hsetlik/CompressorPedal/CompressorPCB/CompressorPCB.kicad_pcb

## KiCad design CompressorPCB/CompressorPCB.kicad_pcb (2026-10-30)

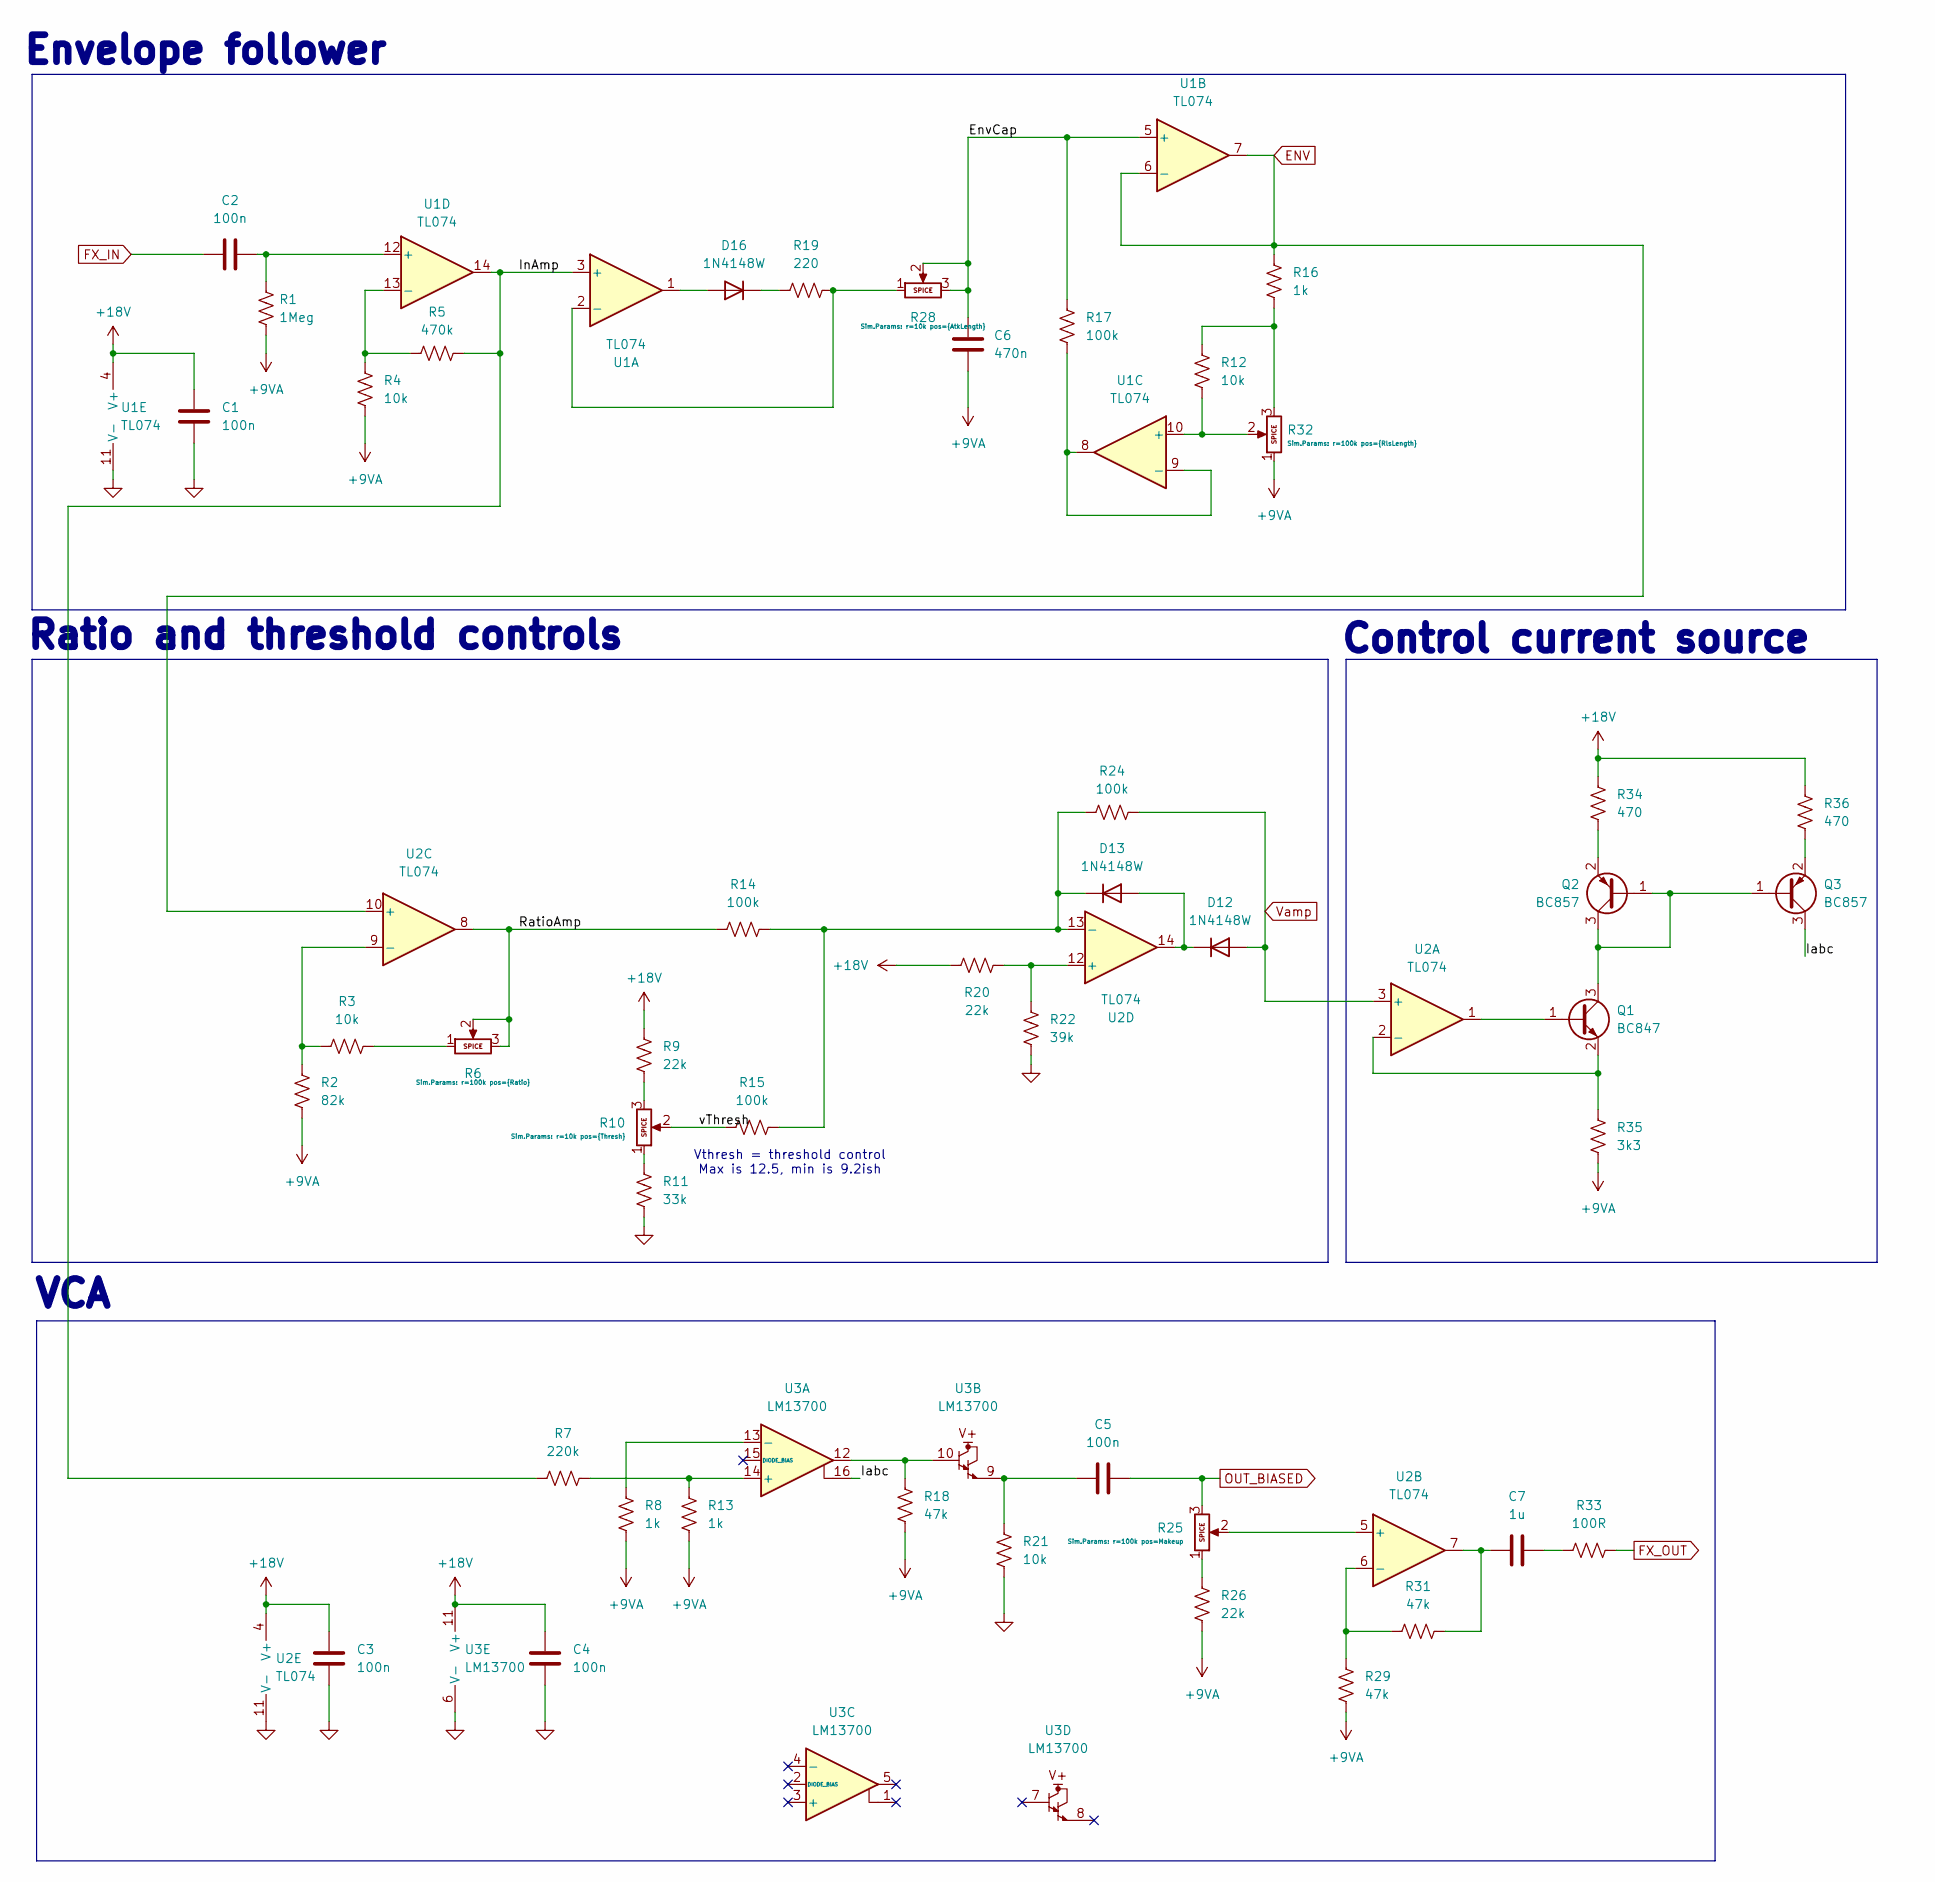
[picture p1: schematic Analog.kicad_sch]

Parts:
C1, C2, C3, C4, C5: 100n; C_0805_2012Metric
C6: 470n; C_0805_2012Metric
C7: 1u; C_0805_2012Metric
D12, D13, D16: 1N4148W; D_SOD-123
Q1: BC847; SOT-23
Q2, Q3: BC857; SOT-23
R1: 1Meg; R_0805_2012Metric
R2: 82k; R_0805_2012Metric
R3, R4, R12, R21: 10k; R_0805_2012Metric
R5: 470k; R_0805_2012Metric
R6, R10, R25, R28, R32: Potentiometer; Potentiometer_Alpha_RV16AF_42_Single_Long
R7: 220k; R_0805_2012Metric
R8, R13, R16: 1k; R_0805_2012Metric
R9, R20, R26: 22k; R_0805_2012Metric
R11: 33k; R_0805_2012Metric
R14, R15, R17, R24: 100k; R_0805_2012Metric
R18, R29, R31: 47k; R_0805_2012Metric
R19: 220; R_0805_2012Metric
R22: 39k; R_0805_2012Metric
R33: 100R; R_0805_2012Metric
R34, R36: 470; R_0805_2012Metric
R35: 3k3; R_0805_2012Metric
U1, U2: TL074; SOIC-14_3.9x8.7mm_P1.27mm
U3: LM13700; SOIC-16_3.9x9.9mm_P1.27mm

Connections:
+9VA: C6.2, R1.2, R2.2, R4.2, R8.2, R13.2, R18.2, R26.2, R29.1, R32.1, R35.1; also elsewhere on the board
+18V: C1.2, C3.2, C4.2, R9.1, R20.1, R34.2, R36.2, U1.4 (V+), U2.4 (V+), U3.11 (V+); also elsewhere on the board
/Analog/EnvCap: C6.1, R17.1, R28.2, R28.3, U1.5 (+)
/Analog/Iabc: Q3.3 (C), U3.16
/Analog/InAmp: R5.2, R7.1, U1.3 (+), U1.14
/Analog/RatioAmp: R6.2, R6.3, R14.1, U2.8
/Analog/vThresh: R10.2, R15.1
ENV: R16.1, U1.6 (-), U1.7, U2.10 (+); also elsewhere on the board
FX_IN: C2.1; also elsewhere on the board
FX_OUT: R33.2; also elsewhere on the board
GND: C1.1, C3.1, C4.1, R11.2, R21.2, R22.1, U1.11 (V-), U2.11 (V-), U3.6 (V-); also elsewhere on the board
unnamed: C5.1, R21.1, U3.9
unnamed: C7.1, R31.2, U2.7
unnamed: C7.2, R33.1
unnamed: D12.1 (K), D13.2 (A), U2.14
unnamed: D13.1 (K), R14.2, R15.2, R24.1, U2.13 (-)
unnamed: D16.2 (A), U1.1
unnamed: D16.1 (K), R19.1
unnamed: Q1.1 (B), U2.1
unnamed: Q1.3 (C), Q2.1 (B), Q2.3 (C), Q3.1 (B)
unnamed: Q1.2 (E), R35.2, U2.2 (-)
unnamed: Q2.2 (E), R34.1
unnamed: Q3.2 (E), R36.1
unnamed: R3.2, R6.1
unnamed: R10.1, R11.1
unnamed: R9.2, R10.3
unnamed: R12.1, R16.2, R32.3
unnamed: R18.1, U3.10, U3.12
unnamed: R25.1, R26.1
unnamed: R19.2, R28.1, U1.2 (-)
unnamed: R12.2, R32.2, U1.10 (+)
unnamed: R17.2, U1.8, U1.9 (-)
unnamed: C2.2, R1.1, U1.12 (+)
unnamed: R4.1, R5.1, U1.13 (-)
unnamed: R25.2, U2.5 (+)
unnamed: R29.2, R31.1, U2.6 (-)
unnamed: R2.1, R3.1, U2.9 (-)
unnamed: R20.2, R22.2, U2.12 (+)
unnamed: R7.2, R13.1, U3.14 (+)
unnamed: R8.1, U3.13 (-)
OUT_BIASED: C5.2, R25.3; also elsewhere on the board
Vamp: D12.2 (A), R24.2, U2.3 (+)

Notes on the sheet:
Vthresh = threshold control Max is 12.5, min is 9.2ish
Envelope follower
VCA
Control current source
Ratio and threshold controls

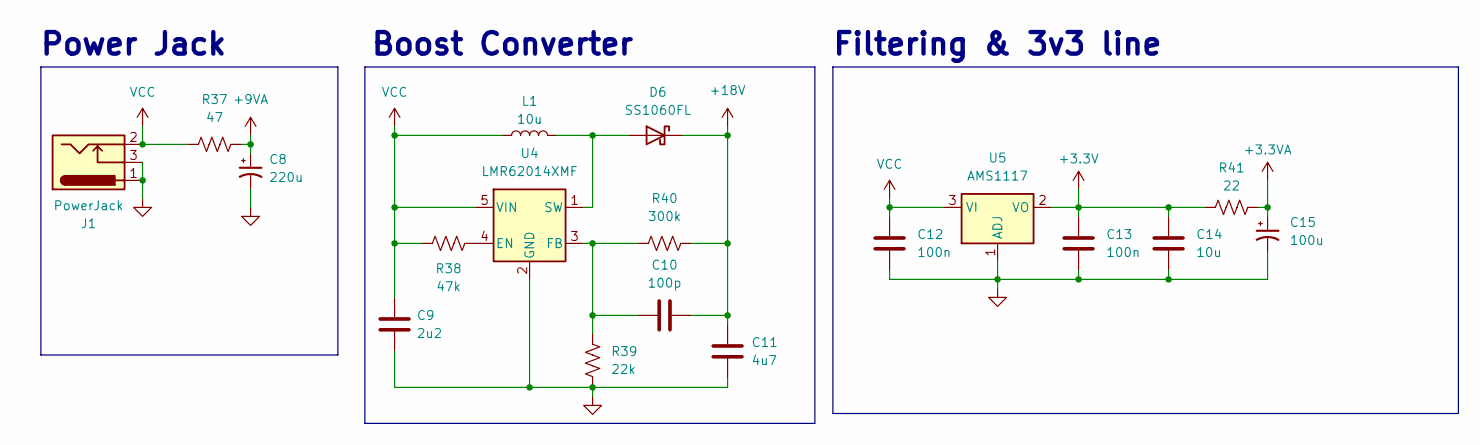
[picture p2: schematic Power.kicad_sch]

Parts:
C8: 220u; CP_Radial_D6.3mm_P2.50mm
C9: 2u2; C_0805_2012Metric
C10: 100p; C_0805_2012Metric
C11: 4u7; C_0805_2012Metric
C12, C13: 100n; C_0805_2012Metric; MPN KGF21BR71H104KT
C14: 10u; C_0805_2012Metric; MPN KGM21AR50J106KU
C15: 100u; CP_Radial_D6.3mm_P2.50mm
D6: SS1060FL; D_SOD-123F
J1: PowerJack; BarrelJack_Horizontal; MPN NEB 21 R-C
L1: 10u; L_SigTransformer_SLPPI04_15
R37: 47; R_0805_2012Metric
R38: 47k; R_0805_2012Metric
R39: 22k; R_0805_2012Metric
R40: 300k; R_0805_2012Metric
R41: 22; R_0805_2012Metric
U4: LMR62014XMF; SOT-23-5
U5: AMS1117; SOT-223-3_TabPin2; MPN LD1117S33CTR

Connections:
+3.3V: C13.2, C14.2, R41.2, U5.2 (VO); also elsewhere on the board
+3.3VA: C15.1, R41.1; also elsewhere on the board
+9VA: C8.1, R37.1; also elsewhere on the board
+18V: C10.2, C11.1, D6.1 (K), R40.2; also elsewhere on the board
GND: C8.2, C9.2, C11.2, C12.1, C13.1, C14.1, C15.2, J1.1, J1.3, R39.1, U4.2 (GND), U5.1 (ADJ); also elsewhere on the board
unnamed: D6.2 (A), L1.2, U4.1 (SW)
unnamed: R38.2, U4.4 (EN)
unnamed: C10.1, R39.2, R40.1, U4.3 (FB)
VCC: C9.1, C12.2, J1.2, L1.1, R37.2, R38.1, U4.5 (VIN), U5.3 (VI)

Notes on the sheet:
Filtering & 3v3 line
Boost Converter
Power Jack

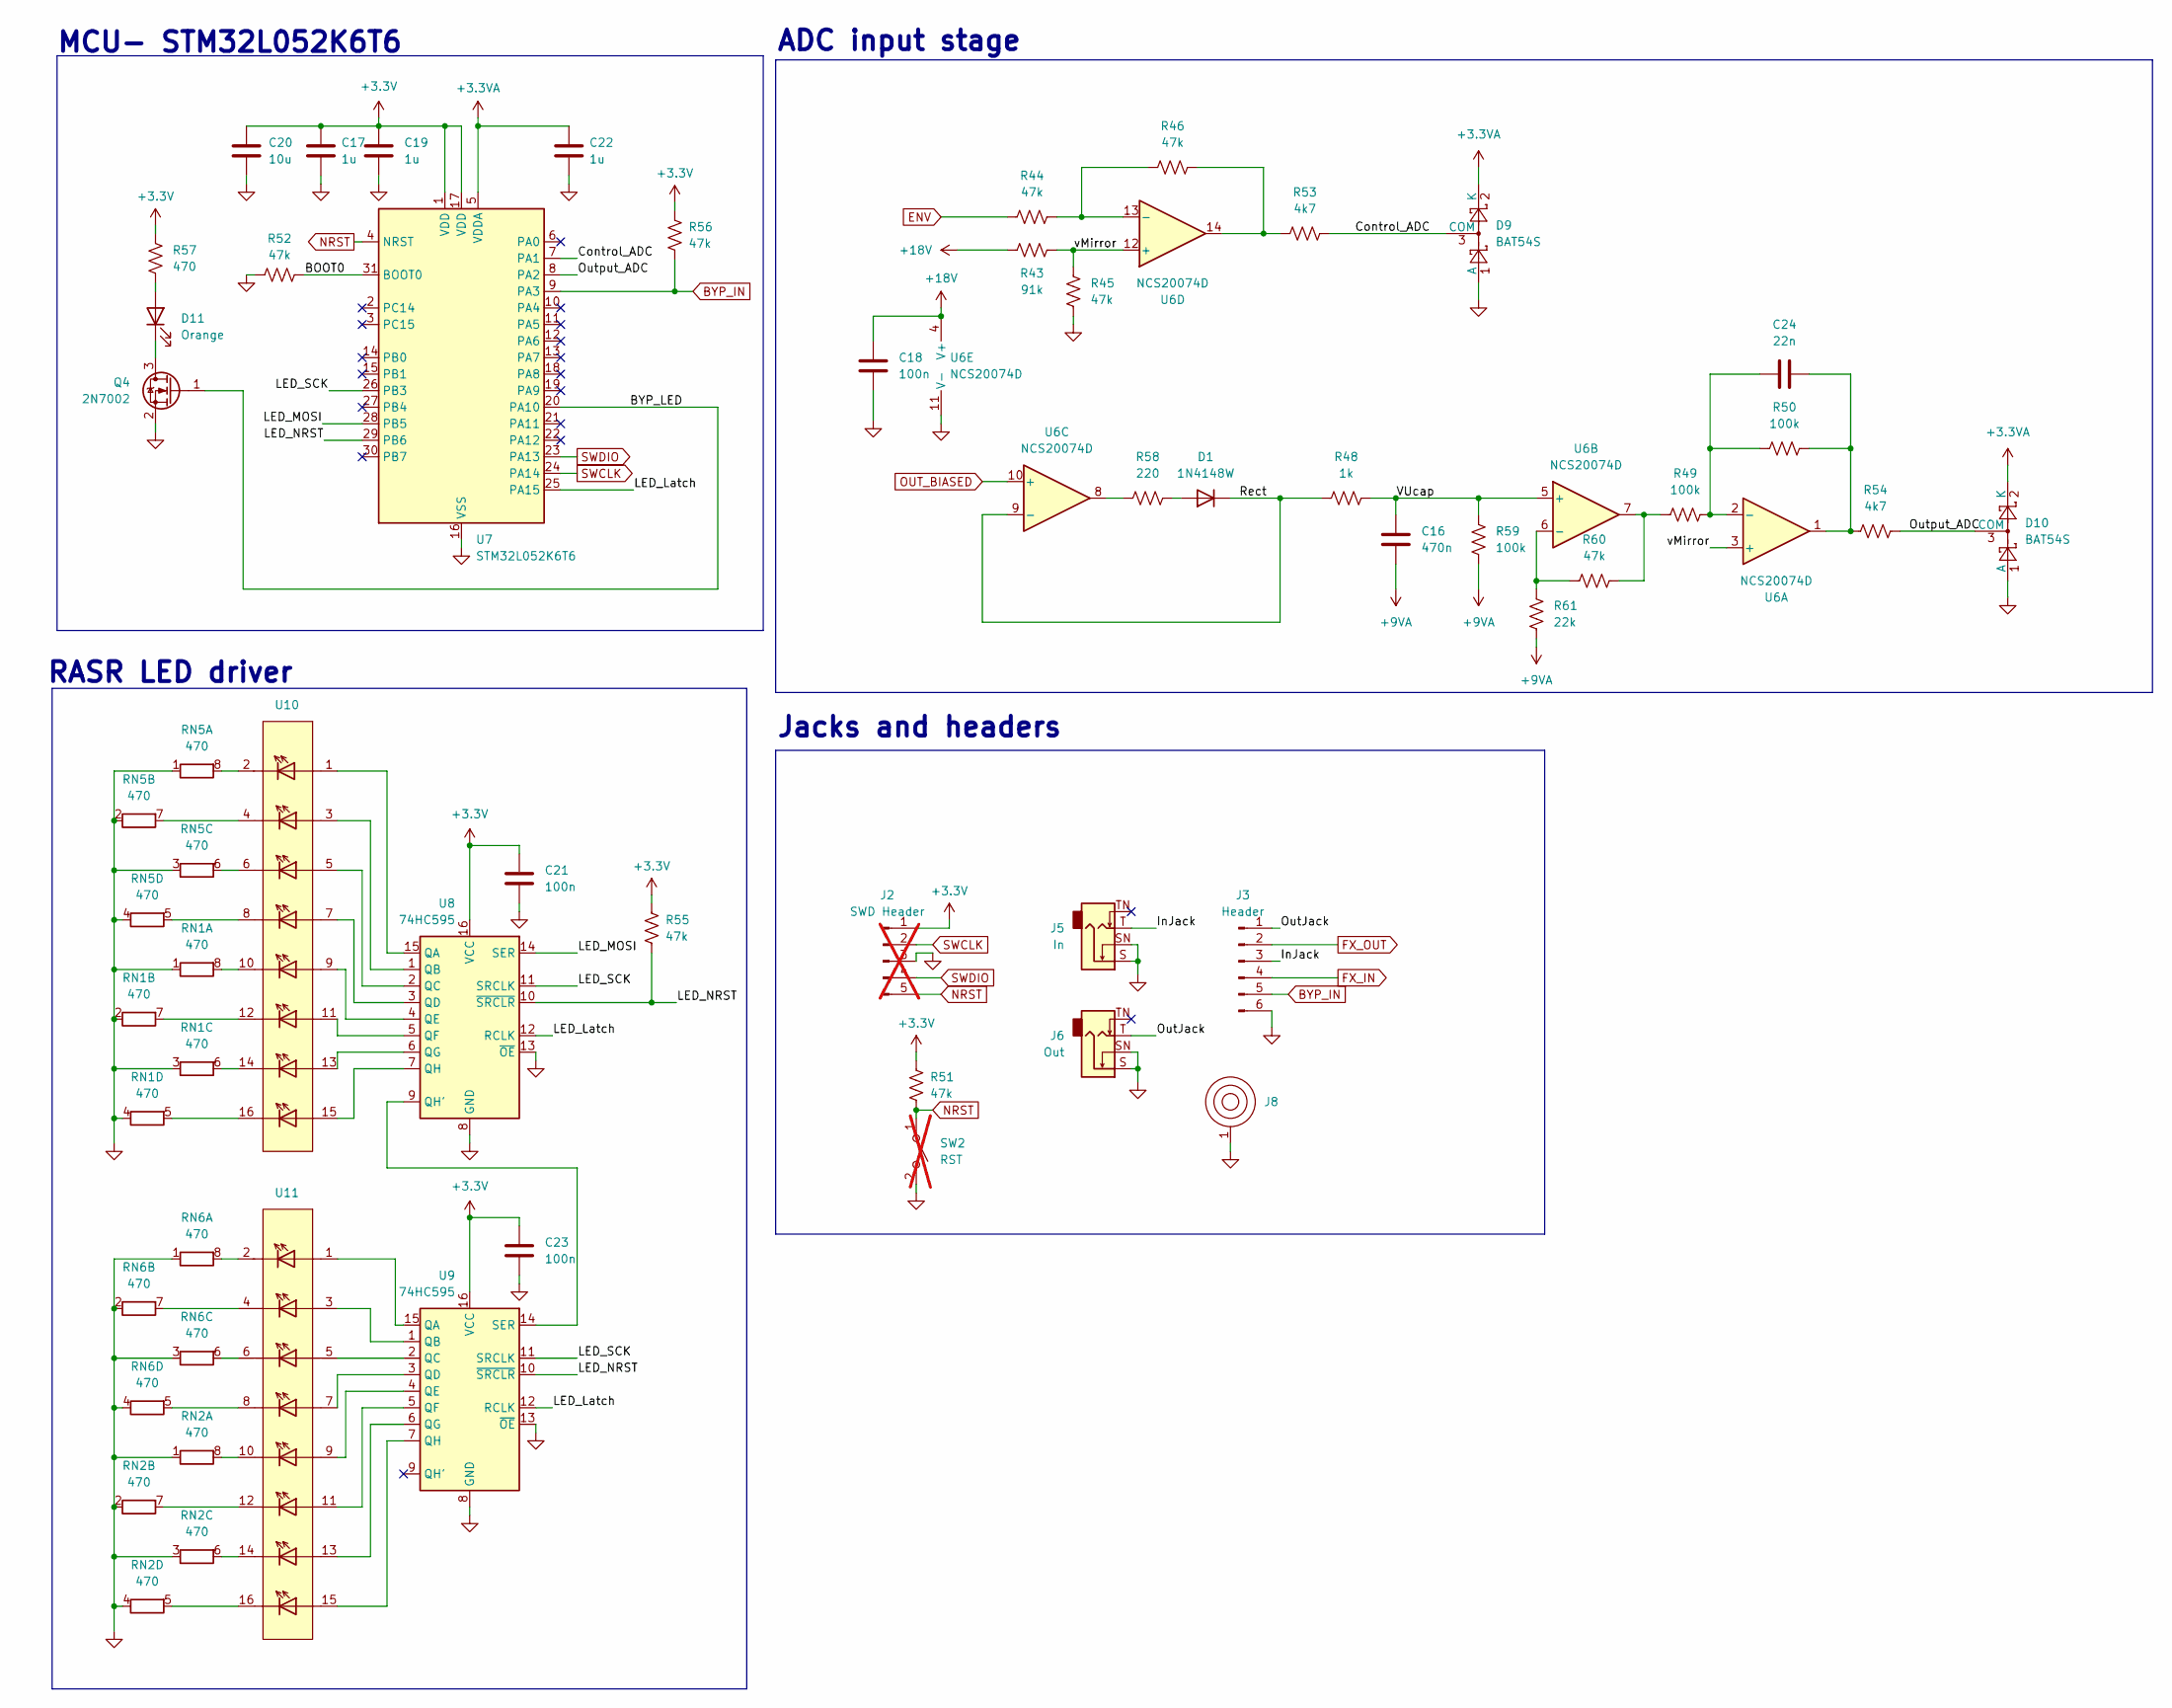
[picture p3: schematic Digital.kicad_sch]

Parts:
C16: 470n; C_0805_2012Metric
C17, C19, C22: 1u; C_0805_2012Metric
C18, C21, C23: 100n; C_0805_2012Metric
C20: 10u; C_0805_2012Metric
C24: 22n; C_0805_2012Metric
D1: 1N4148W; D_SOD-123
D9, D10: BAT54S; SOT-23
D11: Orange; LED_D3.0mm; MPN LTL-4291N
J2: SWD Header; PinHeader_1x05_P2.54mm_Vertical; not fitted
J3: Header; PinHeader_1x06_P2.54mm_Vertical
J5: In; Jack_6.35mm_Tayda_PJ664C_Mono_Horizontal; MPN PJ-644C MONO
J6: Out; Jack_6.35mm_Tayda_PJ664C_Mono_Horizontal; MPN PJ-644C MONO
J8: BatteryContact_Keystone_243
Q4: 2N7002; SOT-23; MPN 2N7002NXAKR
R43: 91k; R_0805_2012Metric
R44, R45, R46, R52, R60: 47k; R_0805_2012Metric
R48: 1k; R_0805_2012Metric
R49, R50, R59: 100k; R_0805_2012Metric
R51, R55, R56: 47k; R_0805_2012Metric; MPN RK73B2ATTE473J
R53, R54: 4k7; R_0805_2012Metric
R57: 470; R_0805_2012Metric; MPN RC0805JR-10470RL
R58: 220; R_0805_2012Metric
R61: 22k; R_0805_2012Metric
RN1, RN2, RN5, RN6: 470; R_Cat16-4
SW2: RST; SW_SPST_B3U-1000P; not fitted
U6: NCS20074D; SOIC-14_3.9x8.7mm_P1.27mm
U7: STM32L052K6T6; LQFP-32_7x7mm_P0.8mm
U8, U9: 74HC595; SOIC-16_3.9x9.9mm_P1.27mm
U10, U11: LED_OctoLED_0805

Connections:
+3.3V: C17.1, C19.1, C20.1, C21.1, C23.1, J2.1, R51.1, R55.1, R56.1, R57.1, U7.1 (VDD), U7.17 (VDD), U8.16 (VCC), U9.16 (VCC); also elsewhere on the board
+3.3VA: C22.1, D9.2 (K), D10.2 (K), U7.5 (VDDA); also elsewhere on the board
+9VA: C16.2, R59.1, R61.2; also elsewhere on the board
+18V: C18.1, R43.1, U6.4 (V+); also elsewhere on the board
/Digital/BOOT0: R52.2, U7.31 (BOOT0)
/Digital/BYP_LED: Q4.1 (G), U7.20 (PA10)
/Digital/Control_ADC: D9.3 (COM), R53.2, U7.7 (PA1)
/Digital/InJack: J3.3, J5.T
/Digital/LED_Latch: U7.25 (PA15), U8.12 (RCLK), U9.12 (RCLK)
/Digital/LED_MOSI: U7.28 (PB5), U8.14 (SER)
/Digital/LED_NRST: R55.2, U7.29 (PB6), U8.10 (~SRCLR), U9.10 (~SRCLR)
/Digital/LED_SCK: U7.26 (PB3), U8.11 (SRCLK), U9.11 (SRCLK)
/Digital/OutJack: J3.1, J6.T
/Digital/Output_ADC: D10.3 (COM), R54.2, U7.8 (PA2)
/Digital/Rect: D1.1 (K), R48.1, U6.9 (-)
/Digital/VUcap: C16.1, R48.2, R59.2, U6.5 (+)
/Digital/vMirror: R43.2, R45.2, U6.3 (+), U6.12 (+)
BYP_IN: J3.5, R56.2, U7.9 (PA3)
ENV: R44.1; also elsewhere on the board
FX_IN: J3.4; also elsewhere on the board
FX_OUT: J3.2; also elsewhere on the board
GND: C17.2, C18.2, C19.2, C20.2, C21.2, C22.2, C23.2, D9.1 (A), D10.1 (A), J2.3, J3.6, J5.S, J5.SN, J6.S, J6.SN, J8.1, Q4.2 (S), R45.1, R52.1, RN1.1 (R1.1), RN1.2 (R2.1), RN1.3 (R3.1), RN1.4 (R4.1), RN2.1 (R1.1), RN2.2 (R2.1), RN2.3 (R3.1), RN2.4 (R4.1), RN5.1 (R1.1), RN5.2 (R2.1), RN5.3 (R3.1), RN5.4 (R4.1), RN6.1 (R1.1), RN6.2 (R2.1), RN6.3 (R3.1), RN6.4 (R4.1), SW2.2 (B), U6.11 (V-), U7.16 (VSS), U7.32 (VSS), U8.8 (GND), U8.13 (~OE), U9.8 (GND), U9.13 (~OE); also elsewhere on the board
NRST: J2.5, R51.2, SW2.1 (A), U7.4 (NRST)
unnamed: C24.2, R50.2, R54.1, U6.1
unnamed: D1.2 (A), R58.2
unnamed: D11.2 (A), R57.2
unnamed: D11.1 (K), Q4.3 (D)
unnamed: R46.2, R53.1, U6.14
unnamed: R49.1, R60.1, U6.7
unnamed: R58.1, U6.8
unnamed: RN1.8 (R1.2), U10.10 (2)
unnamed: RN1.7 (R2.2), U10.12 (2)
unnamed: RN1.6 (R3.2), U10.14 (2)
unnamed: RN1.5 (R4.2), U10.16 (2)
unnamed: RN2.8 (R1.2), U11.10 (2)
unnamed: RN2.7 (R2.2), U11.12 (2)
unnamed: RN2.6 (R3.2), U11.14 (2)
unnamed: RN2.5 (R4.2), U11.16 (2)
unnamed: RN5.8 (R1.2), U10.2
unnamed: RN5.7 (R2.2), U10.4 (2)
unnamed: RN5.6 (R3.2), U10.6 (2)
unnamed: RN5.5 (R4.2), U10.8 (2)
unnamed: RN6.8 (R1.2), U11.2
unnamed: RN6.7 (R2.2), U11.4 (2)
unnamed: RN6.6 (R3.2), U11.6 (2)
unnamed: RN6.5 (R4.2), U11.8 (2)
unnamed: C24.1, R49.2, R50.1, U6.2 (-)
unnamed: R60.2, R61.1, U6.6 (-)
unnamed: R44.2, R46.1, U6.13 (-)
unnamed: U8.15 (QA), U10.1
unnamed: U8.1 (QB), U10.3 (1)
unnamed: U8.2 (QC), U10.5 (1)
unnamed: U8.3 (QD), U10.7 (1)
unnamed: U8.4 (QE), U10.9 (1)
unnamed: U8.5 (QF), U10.11 (1)
unnamed: U8.6 (QG), U10.13 (1)
unnamed: U8.9 (QH'), U9.14 (SER)
unnamed: U8.7 (QH), U10.15 (1)
unnamed: U9.15 (QA), U11.1
unnamed: U9.1 (QB), U11.3 (1)
unnamed: U9.2 (QC), U11.5 (1)
unnamed: U9.3 (QD), U11.7 (1)
unnamed: U9.4 (QE), U11.9 (1)
unnamed: U9.5 (QF), U11.11 (1)
unnamed: U9.6 (QG), U11.13 (1)
unnamed: U9.7 (QH), U11.15 (1)
OUT_BIASED: U6.10 (+); also elsewhere on the board
SWCLK: J2.2, U7.24 (PA14)
SWDIO: J2.4, U7.23 (PA13)

Notes on the sheet:
ADC input stage
Jacks and headers
MCU- STM32L052K6T6
RASR LED driver

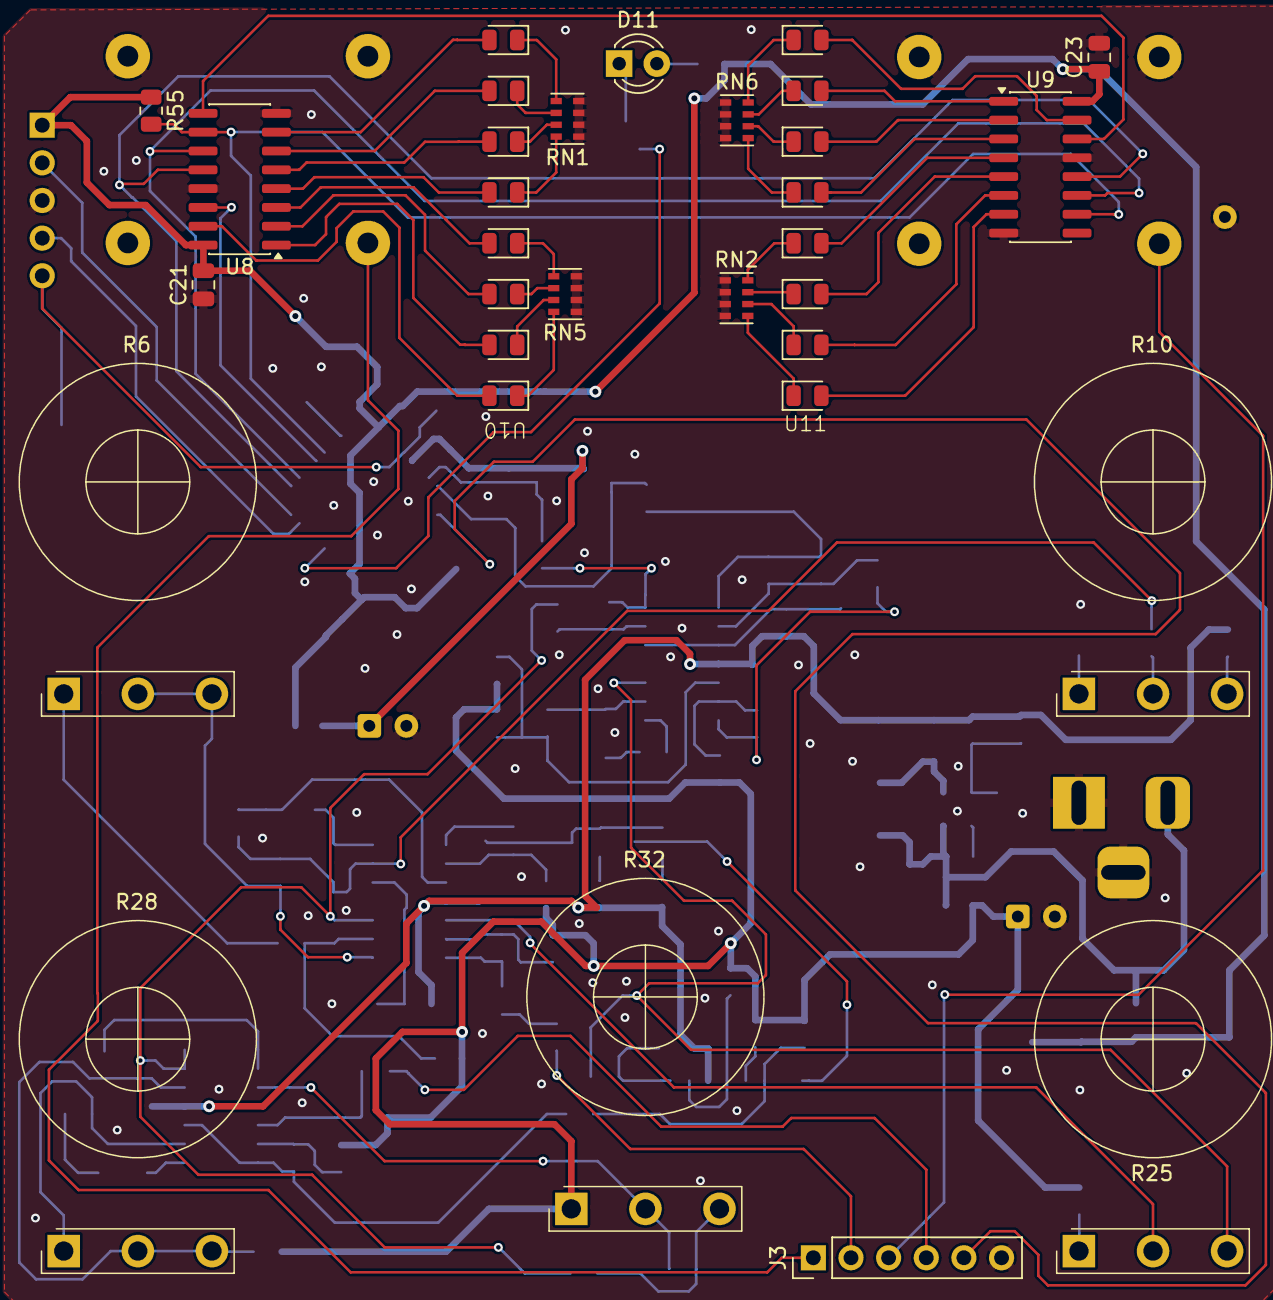
[picture p4: board CompressorPCB.kicad_pcb from above]

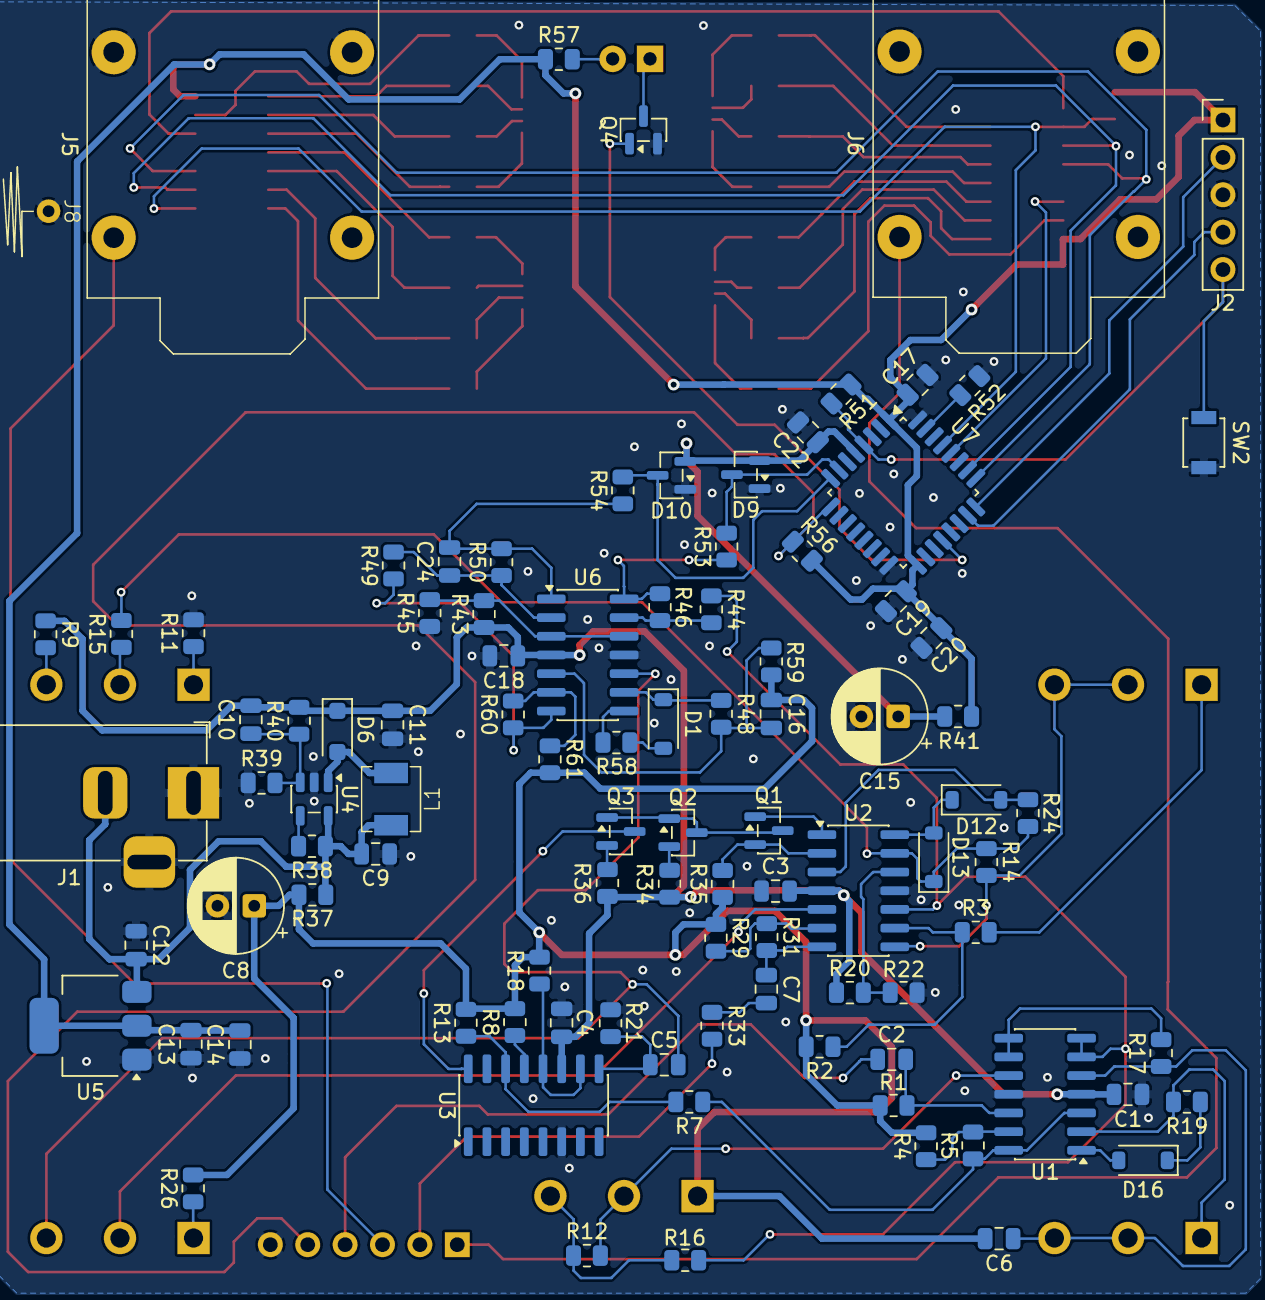
[picture p5: board CompressorPCB.kicad_pcb from below]

Board: 4 copper layers, 115 parts (97 on the bottom side), 108 nets.
