hsetlik/CompressorPedal/Simulations/ADCInputSim/ADCInputSim.kicad_sch

## KiCad design Simulations/ADCInputSim/ADCInputSim.kicad_sch (2026-10-27)

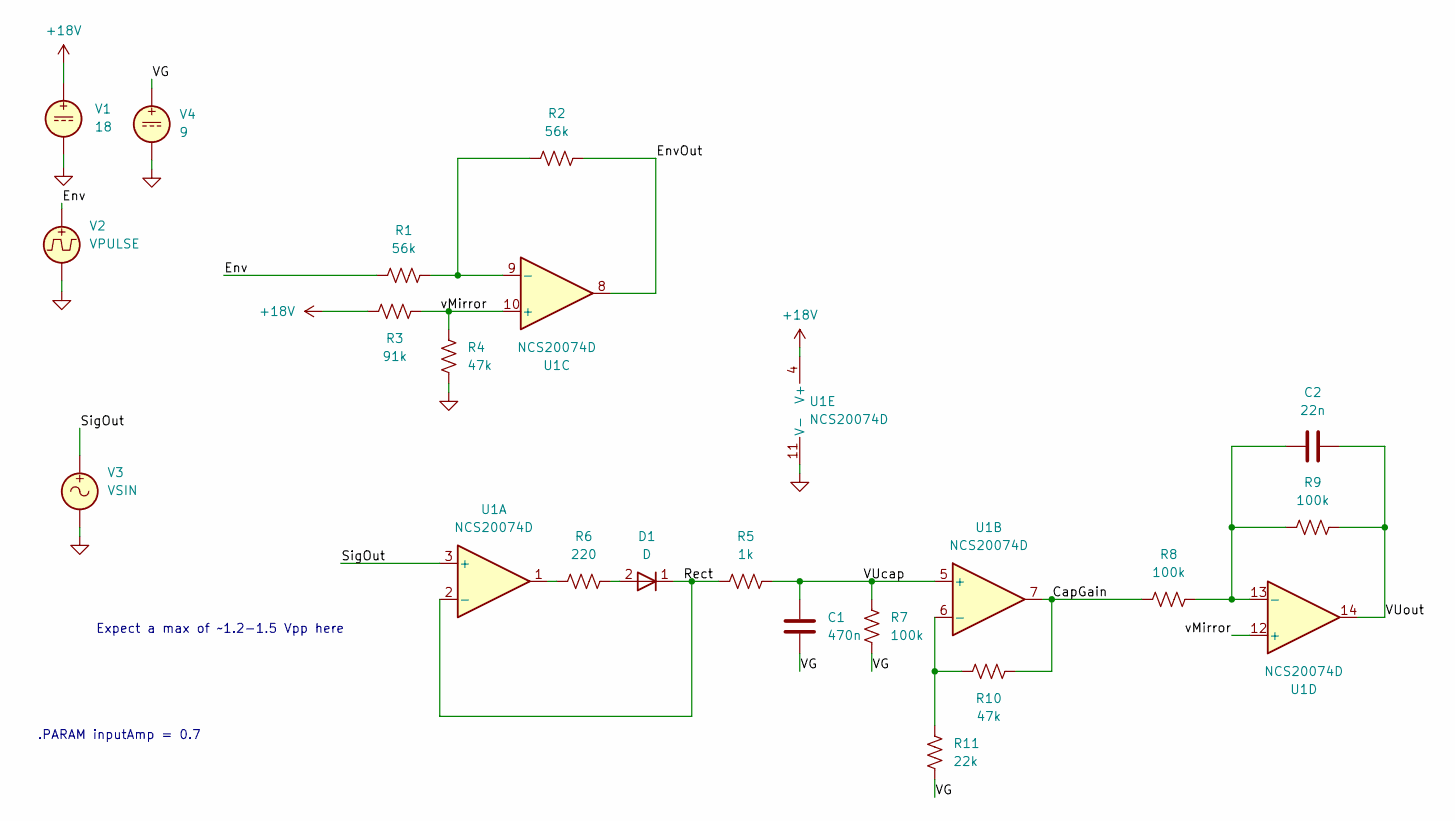
[picture p6: schematic ADCInputSim.kicad_sch]

Parts:
C1: 470n
C2: 22n
D1: D
R1, R2: 56k
R3: 91k
R4, R10: 47k
R5: 1k
R6: 220
R7, R8, R9: 100k
R11: 22k
U1: NCS20074D; SOIC-14_3.9x8.7mm_P1.27mm
V1: 18
V2: VPULSE
V3: VSIN
V4: 9

Connections:
+18V: R3.1, U1.4 (V+), V1.1
CapGain: R8.1, R10.2, U1.7
Env: R1.1, V2.1
EnvOut: R2.2, U1.8
GND: R4.1, U1.11 (V-), V1.2, V2.2, V3.2, V4.2
unnamed: C2.1, R8.2, R9.1, U1.13 (-)
unnamed: D1.2 (A), R6.1
unnamed: R1.2, R2.1, U1.9 (-)
unnamed: R6.2, U1.1
unnamed: R10.1, R11.2, U1.6 (-)
Rect: D1.1 (K), R5.1, U1.2 (-)
SigOut: U1.3 (+), V3.1
VG: C1.2, R7.1, R11.1, V4.1
VUcap: C1.1, R5.2, R7.2, U1.5 (+)
VUout: C2.2, R9.2, U1.14
vMirror: R3.2, R4.2, U1.10 (+), U1.12 (+)

Notes on the sheet:
.PARAM inputAmp = 0.7
Expect a max of ~1.2-1.5 Vpp here
