hsetlik/CompressorPedal/Simulations/CompressorSim/CompressorSim.kicad_sch

## KiCad design Simulations/CompressorSim/CompressorSim.kicad_sch (2026-10-21)

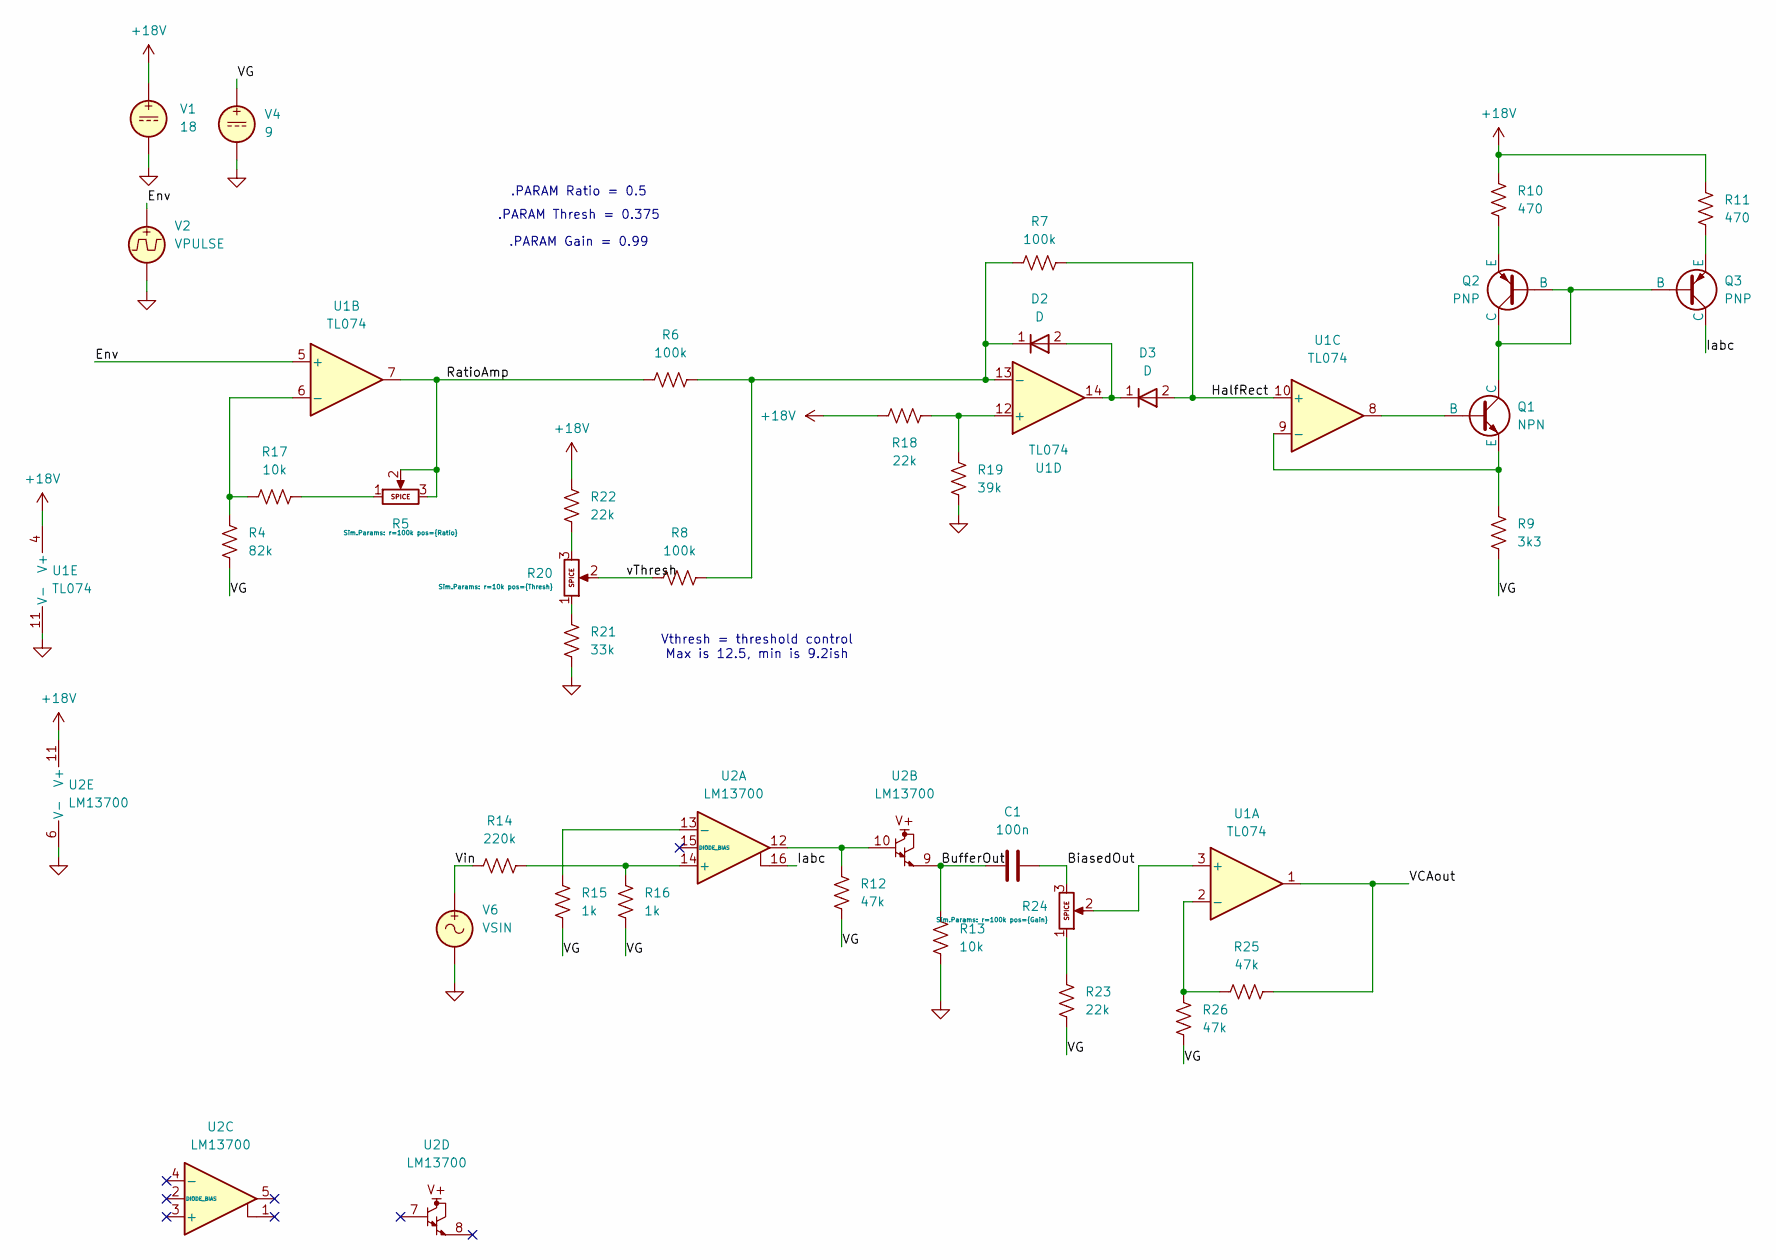
[picture p7: schematic CompressorSim.kicad_sch]

Parts:
C1: 100n
D2, D3: D
Q1: NPN
Q2, Q3: PNP
R4: 82k
R5, R20, R24: Potentiometer
R6, R7, R8: 100k
R9: 3k3
R10, R11: 470
R12, R25, R26: 47k
R13, R17: 10k
R14: 220k
R15, R16: 1k
R18, R22, R23: 22k
R19: 39k
R21: 33k
U1: TL074
U2: LM13700
V1: 18
V2: VPULSE
V4: 9
V6: VSIN

Connections:
+18V: R10.2, R11.2, R18.1, R22.1, U1.4 (V+), U2.11 (V+), V1.1
BiasedOut: C1.2, R24.3
BufferOut: C1.1, R13.1, U2.9
Env: U1.5 (+), V2.1
GND: R13.2, R19.1, R21.2, U1.11 (V-), U2.6 (V-), V1.2, V2.2, V4.2, V6.2
HalfRect: D3.2 (A), R7.2, U1.10 (+)
Iabc: Q3.1 (C), U2.16
unnamed: D2.1 (K), R6.2, R7.1, R8.2, U1.13 (-)
unnamed: D2.2 (A), D3.1 (K), U1.14
unnamed: Q1.1 (C), Q2.1 (C), Q2.2 (B), Q3.2 (B)
unnamed: Q1.2 (B), U1.8
unnamed: Q1.3 (E), R9.2, U1.9 (-)
unnamed: Q2.3 (E), R10.1
unnamed: Q3.3 (E), R11.1
unnamed: R12.1, U2.10, U2.12
unnamed: R14.2, R16.1, U2.14 (+)
unnamed: R15.1, U2.13 (-)
unnamed: R4.1, R17.1, U1.6 (-)
unnamed: R5.1, R17.2
unnamed: R18.2, R19.2, U1.12 (+)
unnamed: R20.1, R21.1
unnamed: R20.3, R22.2
unnamed: R23.1, R24.1
unnamed: R24.2, U1.3 (+)
unnamed: R25.1, R26.2, U1.2 (-)
RatioAmp: R5.2, R5.3, R6.1, U1.7
VCAout: R25.2, U1.1
VG: R4.2, R9.1, R12.2, R15.2, R16.2, R23.2, R26.1, V4.1
Vin: R14.1, V6.1
vThresh: R8.1, R20.2

Notes on the sheet:
Vthresh = threshold control Max is 12.5, min is 9.2ish
.PARAM Gain = 0.99
.PARAM Thresh = 0.375
.PARAM Ratio = 0.5
