hsetlik/CompressorPedal/Simulations/EnvFollowerSim/EnvFollowerSim.kicad_sch

## KiCad design Simulations/EnvFollowerSim/EnvFollowerSim.kicad_sch (2026-10-27)

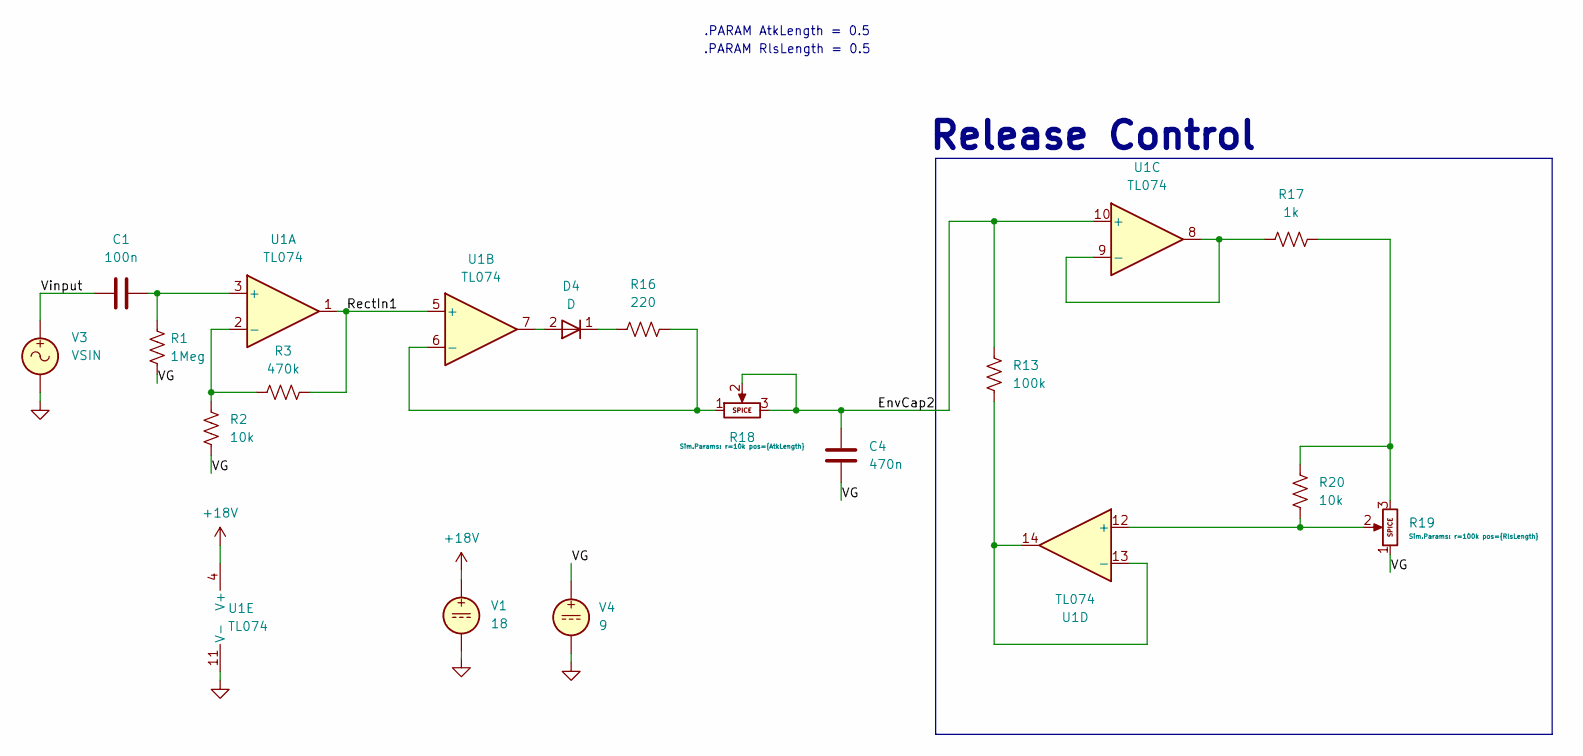
[picture p8: schematic EnvFollowerSim.kicad_sch]

Parts:
C1: 100n
C4: 470n
D4: D
R1: 1Meg
R2, R20: 10k
R3: 470k
R13: 100k
R16: 220
R17: 1k
R18, R19: Potentiometer
U1: TL074
V1: 18
V3: VSIN
V4: 9

Connections:
+18V: U1.4 (V+), V1.1
EnvCap2: C4.1, R13.1, R18.2, R18.3, U1.10 (+)
GND: U1.11 (V-), V1.2, V3.2, V4.2
unnamed: C1.2, R1.1, U1.3 (+)
unnamed: D4.1 (K), R16.1
unnamed: D4.2 (A), U1.7
unnamed: R2.1, R3.1, U1.2 (-)
unnamed: R13.2, U1.13 (-), U1.14
unnamed: R16.2, R18.1, U1.6 (-)
unnamed: R17.1, U1.8, U1.9 (-)
unnamed: R17.2, R19.3, R20.2
unnamed: R19.2, R20.1, U1.12 (+)
RectIn1: R3.2, U1.1, U1.5 (+)
VG: C4.2, R1.2, R2.2, R19.1, V4.1
Vinput: C1.1, V3.1

Notes on the sheet:
Release Control
.PARAM AtkLength = 0.5
.PARAM RlsLength = 0.5
