hsetlik/CompressorPedal/CompressorFirmware/Core/Src/main.c

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
/* Includes ------------------------------------------------------------------*/
#include "main.h"
#include "stm32l0xx_hal_gpio.h"
#include "stm32l0xx_hal_tim.h"

ADC_HandleTypeDef hadc;
DMA_HandleTypeDef hdma_adc;

SPI_HandleTypeDef hspi1;

TIM_HandleTypeDef htim6;
TIM_HandleTypeDef htim21;

/* USER CODE BEGIN PV */
// buffer for the ADC values
// interleaved [IN1, IN2, IN1, IN2, ...], split into two halves for double buffering
// W current timer speeds that means about 187.5 LED updates per second
uint16_t adcBuf[ADC_BUF_SIZE * 4];
// points at the half of adcBuf that the DMA just finished filling
volatile uint16_t* currentBuffer = adcBuf;
volatile uint8_t bufferReady = 0;

norm_range_t controlRange;
norm_range_t outputRange;
volatile bool isBypassed = false;
volatile bool mainTimerRunning = false;
/* USER CODE END PV */

void SystemClock_Config(void);
static void MX_GPIO_Init(void);
static void MX_DMA_Init(void);
static void MX_SPI1_Init(void);
static void MX_ADC_Init(void);
static void MX_TIM6_Init(void);
static void MX_TIM21_Init(void);
/* USER CODE BEGIN PFP */
// call this to set up the norm_ranges
void init_norm_ranges();
// update the LEDs to reflect the latest levels
void update_level_leds(float avg1, float avg2);
/* USER CODE END PFP */

/* USER CODE BEGIN 0 */
float getADC1Average(uint16_t* buf){
  float sum = 0.0f;
  for(uint16_t i = 0; i < ADC_BUF_SIZE; ++i){
    sum += (float)buf[2 * i];
  }
  return sum / (float)ADC_BUF_SIZE;
}
float getADC2Average(uint16_t* buf){
  float sum = 0.0f;
  for(uint16_t i = 0; i < ADC_BUF_SIZE; ++i){
    sum += (float)buf[(2 * i) + 1];
  }

  return sum / (float)ADC_BUF_SIZE;
}
void init_norm_ranges(){
  norm_range_init(&controlRange, CONTROL_ADC_MIN, CONTROL_ADC_MAX, CONTROL_ADC_CENTER);
  norm_range_init(&outputRange, OUTPUT_ADC_MIN, OUTPUT_ADC_MAX, OUTPUT_ADC_CENTER);
}


void update_level_leds(float avg1, float avg2){
  const float controlNorm = norm_range_normalize(&controlRange, avg1);
  const float outputNorm = norm_range_normalize(&outputRange, avg2);
  uint16_t numLEDsControl = (uint16_t)((1.0f - controlNorm) * 8.0f);
  uint16_t numLEDsOutput = (uint16_t)(outputNorm * 8.0f); 
  const uint8_t outputMask = 0xFF >> (8 - numLEDsOutput);
  const uint8_t controlMask = 0xFF >> (8 - numLEDsControl);
  uint8_t ledData[2] = {outputMask, controlMask};
  HAL_SPI_Transmit(&hspi1,  ledData, 2, HAL_MAX_DELAY); 
}
/* USER CODE END 0 */

/**
  * @brief  The application entry point.
  * @retval int
  */
int main(void)
{

  /* MCU Configuration--------------------------------------------------------*/

  /* Reset of all peripherals, Initializes the Flash interface and the Systick. */
  HAL_Init();

  /* Configure the system clock */
  SystemClock_Config();

  /* Initialize all configured peripherals */
  MX_GPIO_Init();
  MX_DMA_Init();
  MX_SPI1_Init();
  MX_ADC_Init();
  MX_TIM6_Init();
  MX_TIM21_Init();
  /* USER CODE BEGIN 2 */
  // calibrate before the ADC is enabled
  if (HAL_ADCEx_Calibration_Start(&hadc, ADC_SINGLE_ENDED) != HAL_OK)
  {
    Error_Handler();
  }
  // arm the ADC + circular DMA, conversions wait for TIM6 TRGO
  if (HAL_ADC_Start_DMA(&hadc, (uint32_t*)adcBuf, ADC_BUF_SIZE * 4) != HAL_OK)
  {
    Error_Handler();
  }
  // start the timer last so the first trigger isn't missed
  if (HAL_TIM_Base_Start(&htim6) != HAL_OK)
  {
    Error_Handler();
  }
  mainTimerRunning = true;
  // set the bypass LED state
  HAL_GPIO_WritePin(BYP_LED_GPIO_Port, BYP_LED_Pin, (GPIO_PinState)!isBypassed);
  // start the timer to check the bypass switch
  if (HAL_TIM_Base_Start_IT(&htim21) != HAL_OK){
    Error_Handler();
  }
  // initialize the norm ranges
  init_norm_ranges();
  /* USER CODE END 2 */

  /* Infinite loop */
  /* USER CODE BEGIN WHILE */
  while (1)
  {
    if(bufferReady){
      const float lvl1 = getADC1Average(currentBuffer);
      const float lvl2 = getADC2Average(currentBuffer);
      update_level_leds(lvl1, lvl2);
      bufferReady = 0;
    }
    /* USER CODE END WHILE */

    /* USER CODE BEGIN 3 */
  }
  /* USER CODE END 3 */
}

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
/* USER CODE BEGIN 4 */
// first half of adcBuf is full, DMA is now writing the second half
void HAL_ADC_ConvHalfCpltCallback(ADC_HandleTypeDef* hadc)
{
  currentBuffer = adcBuf;
  bufferReady = 1;
}

// second half of adcBuf is full, DMA has wrapped back to the first half
void HAL_ADC_ConvCpltCallback(ADC_HandleTypeDef* hadc)
{
  currentBuffer = adcBuf + (ADC_BUF_SIZE * 2);
  bufferReady = 1;
}

void HAL_TIM_PeriodElapsedCallback(TIM_HandleTypeDef *htim){
  const bool currentPinState = (bool)HAL_GPIO_ReadPin(BYP_IN_GPIO_Port, BYP_IN_Pin);
  if(currentPinState != isBypassed){
    isBypassed = currentPinState;
    HAL_GPIO_WritePin(BYP_LED_GPIO_Port, BYP_LED_Pin, (GPIO_PinState)!isBypassed);
  }
}
/* USER CODE END 4 */
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
