hsetlik/CompressorPedal/CompressorFirmware/CompressorFirmware.ioc

Mcu.UserName=STM32L052K6Tx
PA1.GPIO_Label=CONTROL_ADC
PA1.Signal=ADC_IN1
PA10.GPIO_Label=BYP_LED
PA10.Signal=GPIO_Output
PA13.Signal=SYS_SWDIO
PA14.Signal=SYS_SWCLK
PA15.GPIO_Label=LED_LATCH
PA15.Signal=SPI1_NSS
PA2.GPIO_Label=OUTPUT_ADC
PA2.Signal=ADC_IN2
PA3.GPIO_Label=BYP_IN
PA3.Signal=GPIO_Input
PB3.GPIO_Label=LED_SCK
PB3.Signal=SPI1_SCK
PB5.GPIO_Label=LED_MOSI
PB5.Signal=SPI1_MOSI
PB6.GPIO_Label=LED_NRST
PB6.Signal=GPIO_Output
