hsetlik/CompressorPedal/CompressorFirmware/Core/Inc/main.h

#define ADC_BUF_SIZE 64
#define CONTROL_ADC_MIN 50.0f
#define CONTROL_ADC_MAX 4095.0f
#define CONTROL_ADC_CENTER 1700.0f
#define OUTPUT_ADC_MIN 50.0f
#define OUTPUT_ADC_MAX 4095.0f
#define OUTPUT_ADC_CENTER 1700.0f
#define CONTROL_ADC_Pin GPIO_PIN_1
#define CONTROL_ADC_GPIO_Port GPIOA
#define OUTPUT_ADC_Pin GPIO_PIN_2
#define OUTPUT_ADC_GPIO_Port GPIOA
#define BYP_IN_Pin GPIO_PIN_3
#define BYP_IN_GPIO_Port GPIOA
#define BYP_LED_Pin GPIO_PIN_10
#define BYP_LED_GPIO_Port GPIOA
#define LED_LATCH_Pin GPIO_PIN_15
#define LED_LATCH_GPIO_Port GPIOA
#define LED_SCK_Pin GPIO_PIN_3
#define LED_SCK_GPIO_Port GPIOB
#define LED_MOSI_Pin GPIO_PIN_5
#define LED_MOSI_GPIO_Port GPIOB
#define LED_NRST_Pin GPIO_PIN_6
#define LED_NRST_GPIO_Port GPIOB
