hsetlik/CompressorPedal/(commit log)

2026-10-20 initia commit
    [CompressorSim.kicad_pcb, CompressorSim.kicad_sch, EnvFollowerSim.kicad_pcb, EnvFollowerSim.kicad_sch]
2026-10-21 env detector sim tweaks
    [EnvFollowerSim.kicad_sch]
2026-10-21 compressor simulation
    [CompressorSim.kicad_sch]
2026-10-21 VCA and current source sim
    [CompressorSim.kicad_sch]
2026-10-21 ADC input stage sim
    [ADCInputSim.kicad_pcb, ADCInputSim.kicad_sch, CompressorSim.kicad_pcb, CompressorSim.kicad_sch, EnvFollowerSim.kicad_pcb, EnvFollowerSim.kicad_sch]
2026-10-21 voltage divider values picked
    [CompressorSim.kicad_sch]
2026-10-21 compressor sim upgrades
    [Analog.kicad_sch, CompressorPCB.kicad_pcb, CompressorPCB.kicad_sch, CompressorSim.kicad_sch, EnvFollowerSim.kicad_sch]
2026-10-21 analog and power section schematics
    [Analog.kicad_sch, CompressorPCB.kicad_sch, CompressorSim.kicad_sch, Power.kicad_sch]
2026-10-21 ADC driver dialed in
    [ADCInputSim.kicad_sch, Analog.kicad_sch, CompressorSim.kicad_sch]
2026-10-21 switched to NCS2007x op-amp
    [ADCInputSim.kicad_sch]
2026-10-21 basic firmware
    [ADCInputSim.kicad_sch, CompressorPCB.kicad_sch, Digital.kicad_sch]
2026-10-21 digital side schematic stuff
    [Digital.kicad_sch]
2026-10-21 shift register LED driver
    [Digital.kicad_sch]
2026-10-22 schematic labels, footprints chosen
    [Analog.kicad_sch, Digital.kicad_sch]
2026-10-22 1590bb dimensions drawn
    [CompressorPCB.kicad_pcb]
2026-10-22 fixed resistor array footprints
    [CompressorPCB.kicad_pcb, Digital.kicad_sch]
2026-10-22 basic layout
    [Analog.kicad_sch, CompressorPCB.kicad_pcb, Digital.kicad_sch]
2026-10-22 routing start
    [CompressorPCB.kicad_pcb]
2026-10-23 all routed, no DRC
    [CompressorPCB.kicad_pcb, Digital.kicad_sch]
2026-10-27 updated env. follower and ADC driver in schem
    [ADCInputSim.kicad_sch, Analog.kicad_sch, Digital.kicad_sch, EnvFollowerSim.kicad_sch]
2026-10-27 all routed, DRC passing
    [Analog.kicad_sch, CompressorPCB.kicad_pcb]
2026-10-27 added bypass switch checking
2026-10-30 elbow room, stitching vias
    [CompressorPCB.kicad_pcb]
